ahsanali78/duroc-50-wheel-holder/Bicycle_wheel_holder.3mf

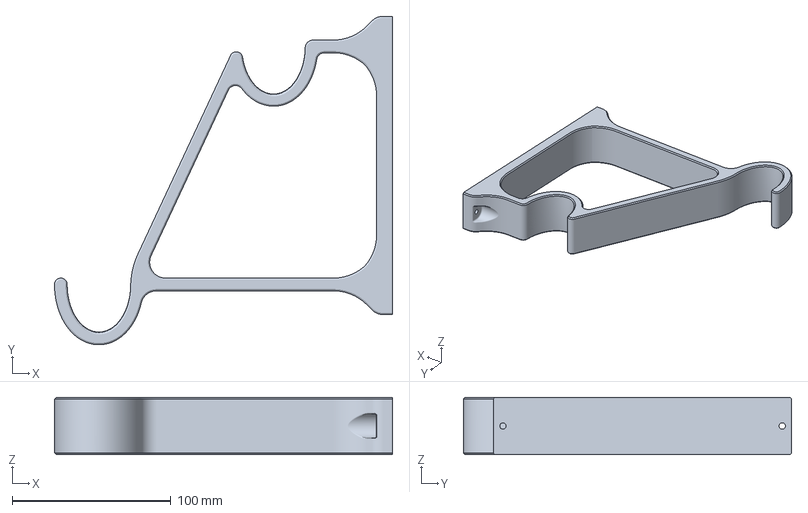
[picture p4: CAD file, 2026-11-11]
Bicycle_wheel_holder.3mf
213.0 x 207.0 x 36.0 mm
