ahsanali78/duroc-50-wheel-holder/Bicycle_wheel_holder_29plus_Duroc50.step

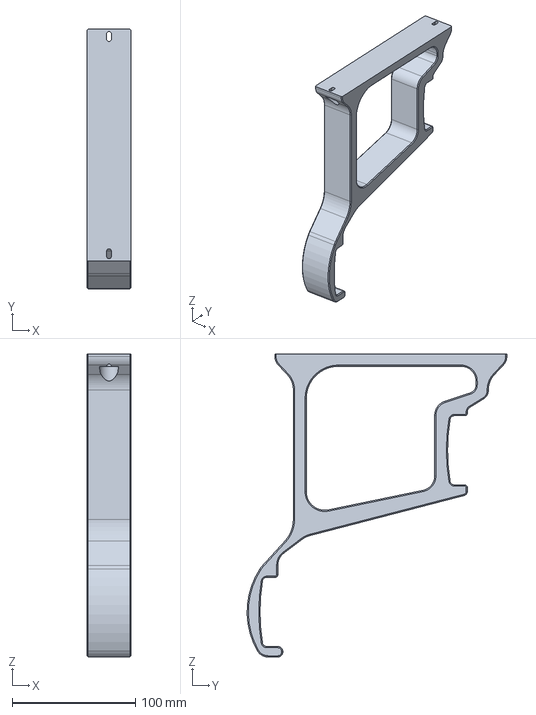
[picture p5: CAD file, 2026-11-11]
Bicycle_wheel_holder_29plus_Duroc50.step
36.0 x 210.5 x 245.5 mm
