ahsanali78/duroc-50-wheel-holder/(list of files, cad)

Other CAD files:
Bicycle_wheel_holder_29plus_Duroc50.3mf
Bicycle_wheel_holder_29plus_Duroc50.stl
